OUSmartInfrastructure/raingardenSensor/images/athensCcSign01.jpg

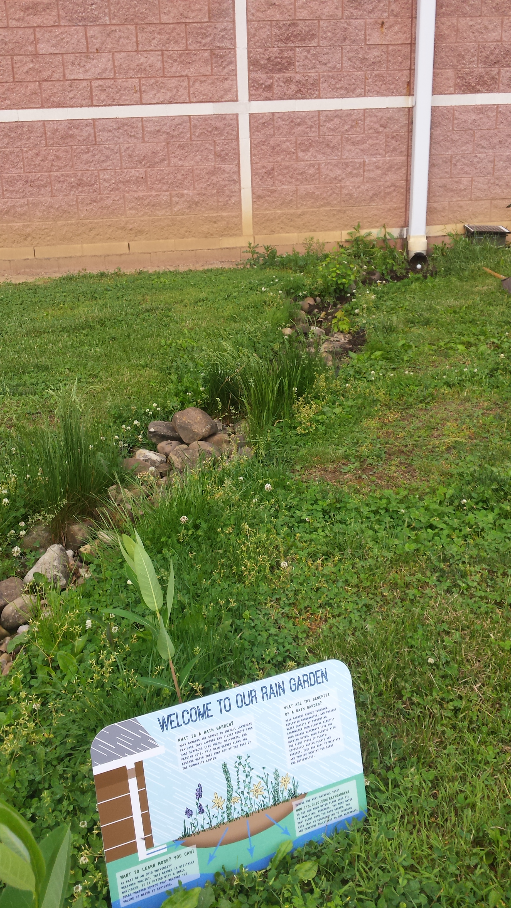
images/athensCcSign01.jpg
