OUSmartInfrastructure/raingardenSensor/images/athensCcSign02.jpg

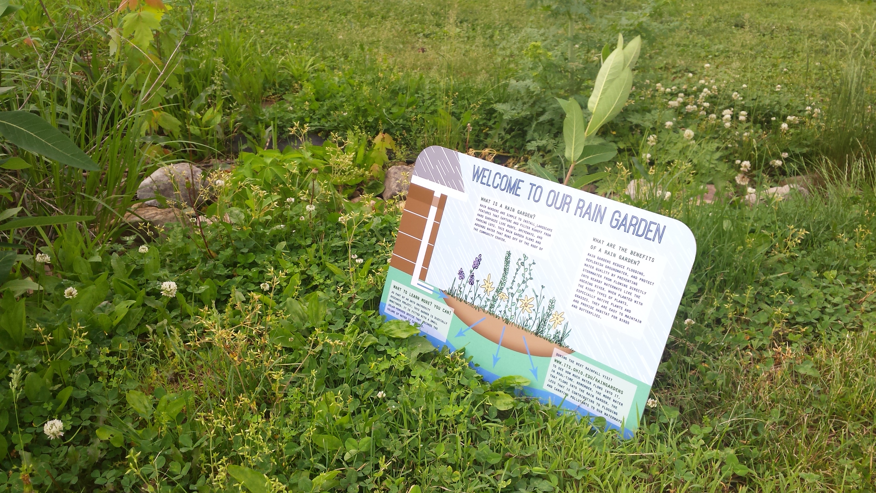
images/athensCcSign02.jpg
