OUSmartInfrastructure/raingardenSensor/images/athensCeORaingarden.jpg

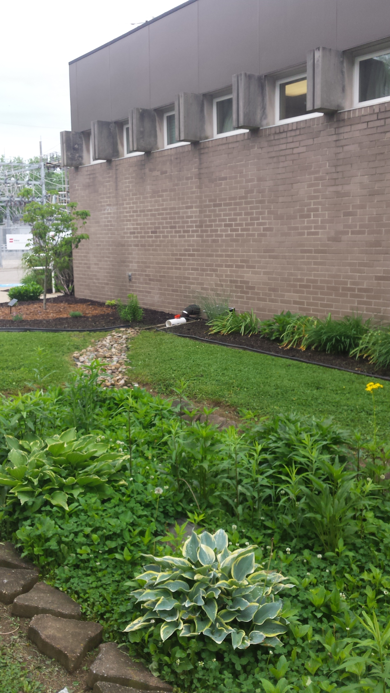
images/athensCeORaingarden.jpg
