OUSmartInfrastructure/raingardenSensor/images/pvcMount3DDetail.png

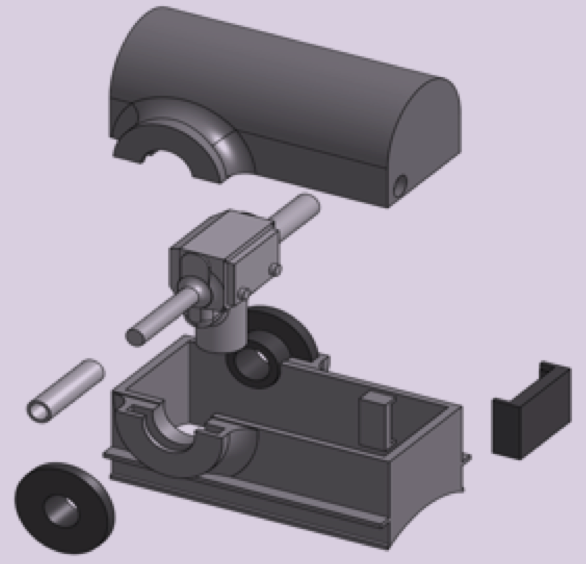
images/pvcMount3DDetail.png
